timofei7/TiNZv1/schematics/engs31 - package map.graffle/image1.jpg

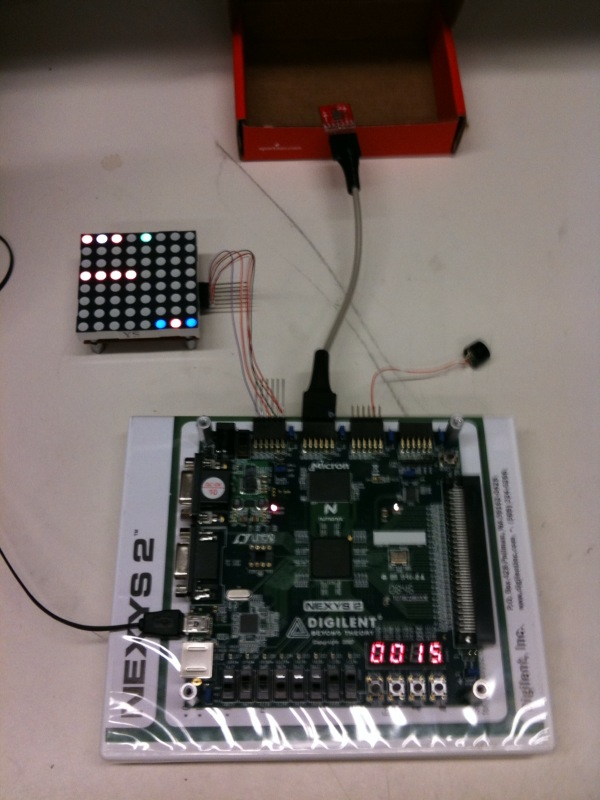
schematics/engs31 - package map.graffle/image1.jpg
