timofei7/TiNZv1/levelCreator/testphoto.jpg

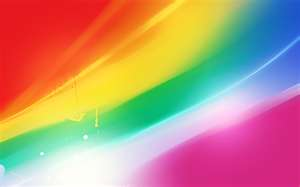
levelCreator/testphoto.jpg
