timofei7/TiNZv1/README.md

##TiNZ v1##

ENGS 31 - Summer 2009
Final Project

[Video Demo](http://www.youtube.com/embed/jcJoUI1PBZo?rel=0&amp;hd=1)

Our goal for this project was to create a simple, but addicting game that played off of old-fashioned handheld and vintage arcade games, but utilized newer technology that allowed for a more modern feel and the implementation of more exciting features. This is a reinvention of the original tilt-maze game as a digital moving maze on an RBG 8x8 LED matrix controlled via accelerometer.  It takes the tilt as input to move the player on the board.  There is seven-segment display showing the timer and score. A piezo is also included to produce different sounds for specific actions in the game. These components contribute to a gaming experience that is stimulating both tactilely, visually and aurally. The game design also makes the game easy to reprogram to include more levels and additional features.  The included maze designs include a multicolor fire-spewing dragon, a volcano, and an alien space ship with lasers.

##Detaiils##

The basic components of the project:

* Xilinx FPGA board
* VHDL (digital circuit) code
* Accelerometer chip
* LED multi-segment RGB display
* Piezo
* 3D case model (rapid prototyped)

Copyright 2009 Tim Tregubov and Divya Gunasekaran

<br /><span xmlns:dct="http://purl.org/dc/terms/" href="http://purl.org/dc/dcmitype/Text" property="dct:title" rel="dct:type">TiNZ v1</span> by <a xmlns:cc="http://creativecommons.org/ns#" href="https://github.com/timofei7/TiNZv1" property="cc:attributionName" rel="cc:attributionURL">Divya Gunasekaran and Tim Tregubov</a> is licensed under a <a rel="license" href="http://creativecommons.org/licenses/by-nc-sa/3.0/">Creative Commons Attribution-NonCommercial-ShareAlike 3.0 Unported License</a>
