timofei7/TiNZv1/schematics/frontpanel.graffle/QuickLook/Preview.pdf

TINZ - Front Panel

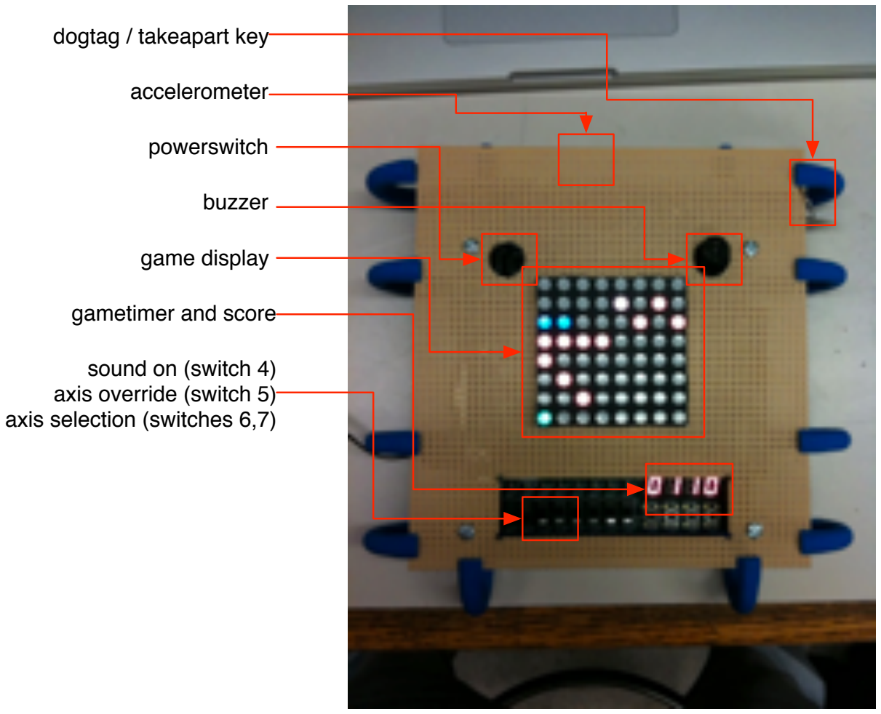
[picture p7: figure]
powerswitch; buzzer; game display; gametimer and score; sound on (switch 4) axis override (switch 5) axis selection (switches 6,7); accelerometer; dogtag / takeapart key
