timofei7/TiNZv1/schematics/engs31 - package map.graffle/QuickLook/Preview.pdf

TINZ - Package Map

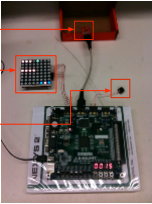
[picture p8: figure]

Sparkfun
8x8 RGB Serial LED

Sparkfun ADXL213AE
Breakout Board

Piezo Buzzer
CEM-1203(42)
