timofei7/TiNZv1/schematics/frontpanel.graffle/image1.jpg

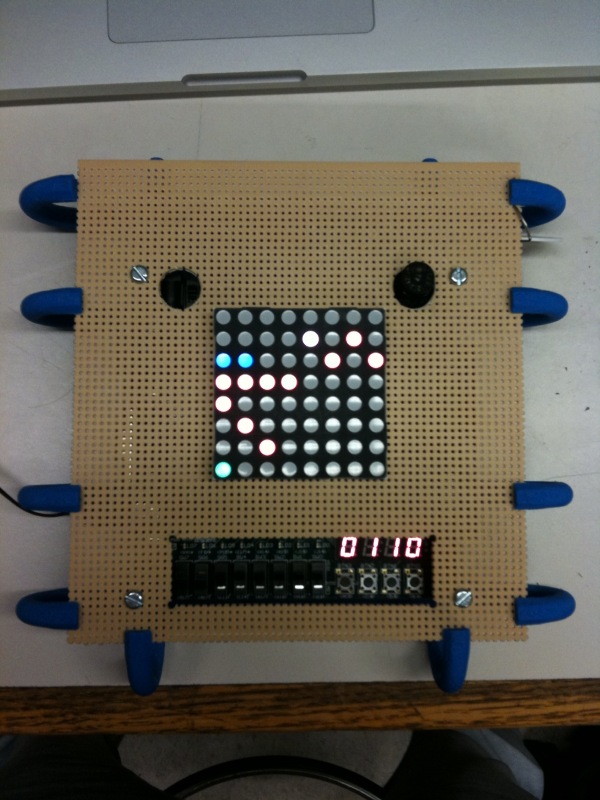
schematics/frontpanel.graffle/image1.jpg
