timofei7/TiNZv1/Project/LEDDriver.vhd

----------------------------------------------------------------------------------
-- DARTMOUTH COLLEGE - ENGS31
-- Divya Gunasekaran and Tim Tregubov
-- Final Project
-- September 1, 2009
-- 
-- Create Date:    13:17:46 08/15/2009 
-- Design Name: 
-- Module Name:    LEDDriver - Behavioral
-- Project Name: 	 TINZ (This Is Not Zelda)
-- 
-- Description:    the SPI driver for the LED display
--
----------------------------------------------------------------------------------
library IEEE;
use IEEE.STD_LOGIC_1164.ALL;
use ieee.numeric_std.all;

entity LEDDriver is
    Port ( Clk : in  STD_LOGIC;
           Data: in STD_LOGIC; --the data in bit from the data shift register from Display
           GoDisplay : in  STD_LOGIC;  --in from Display says data register is full up
           ShiftBitOut : out STD_LOGIC; --tells display I'm ready for the next bit
           displayDone : out STD_LOGIC; --tells display that we're done sending, do your thing. 
           --MISO : in  STD_LOGIC;
           MOSI : out  STD_LOGIC; --spi out to display
           SCLK : out  STD_LOGIC; --spi clock
           CS : out  STD_LOGIC);  --spi enable
end LEDDriver;

architecture Behavioral of LEDDriver is

   
-- state machine for SPI bus
type state_type is (sIdle, sInit, sWaitS, sSendInit, sSendDown, sSendM, sSendUP, sDeInit, sWaitD);	-- state machine
signal curr_state: state_type := sIdle;
signal next_state: state_type;

constant waitFinal: unsigned(14 downto 0) := "110000110101000"; -- 25,000 * 20ns = .5ms delay 
--constant waitFinal: unsigned(14 downto 0) := "000000000000100"; -- FOR TESTING - remember this counts from 0
signal waitCount: unsigned(14 downto 0) := (others => '0'); --counts for the initial wait
signal waitTC : std_logic:='0'; --terminal count
signal waitReset : std_logic:='0'; --reset the wait counter

--constant slowFinal: unsigned(7 downto 0) := "11111010"; --count to 250 for a rate of 100khz in for down/up of SCLK
constant slowFinal: unsigned(7 downto 0) := "11111010"; --FOR TESTING
signal slowCount: unsigned(7 downto 0) := (others => '0'); --counts for SCLK
signal slowTC : std_logic:='0'; --terminal count
signal slowReset : std_logic:='0'; --reset the wait counters

constant shiftFinal: unsigned(9 downto 0):= "1000000000"; --final count 512
signal shiftCount: unsigned(9 downto 0):= (others => '0'); --count shifts
signal shiftBit: std_logic:='0'; --shift our bits out onto MOSIs
signal shiftTC: std_logic:='0'; --shift terminal count

--signal displayDoneReg: std_logic:='1'; --low when I'm active high when I'm not

signal csy: std_logic:='0'; --internal CS sig

begin

MOSI <= Data; --we shift out datas from this shift register from Display
shiftBitOut <= shiftBit; --just a hookup of internal to external
displayDone <= csy; --do it or rather don't
CS <= csy;




waitCounter: --15bit up counter to enable .5ms pause
process(Clk)
   begin
      if rising_edge(Clk) then
         if waitReset = '1' then
            waitCount <= (others => '0');
         else
            waitCount <= waitCount + 1;
         end if;
      end if;
end process waitCounter;
waitTC <= '1' when waitCount = waitFinal else '0';


slowCounter: --15bit up counter to enable .5ms pause
process(Clk)
   begin
      if rising_edge(Clk) then
         if slowReset = '1' then
            slowCount <= (others => '0');
         else
            slowCount <= slowCount + 1;
         end if;
      end if;
end process slowCounter;
slowTC <= '1' when slowCount = slowFinal else '0';


shiftCounter: --just counts shifts so we don't ask for more than we need
process(Clk)
   begin
      if rising_edge(Clk) then
         if shiftTC = '1' then
            shiftCount <= (others => '0');
         elsif shiftBit = '1' then
            shiftCount <= shiftCount + 1;
         end if;
      end if;
end process shiftCounter;

statemachine: --state machine to do all the work
process(curr_state, GoDisplay, waitTC, shiftCount, slowTC, slowCount)
   begin
   next_state <= curr_state;
   csy <= '0'; --opposite default - this is active low but we only set it high false during sIdle
   shiftBit <= '0';
   waitReset <= '0';
   slowReset <= '0';
   SCLK <= '0';
   shiftTC <= '0';
   
   case curr_state is
      when sIdle => --base state - CS is high false
         csy <= '1';
         if GoDisplay = '1' then
            next_state <= sInit;
         end if;
      when sInit => --resest counters to deassert cs
         csy<= '1';
         waitReset <= '1';
         next_state <= sWaitS;
      when sWaitS => --wait for .5ms after deasserting cs
         if waitTC = '1' then
            next_state <= sSendInit;
         end if;
      when sSendInit => --reset counts to initialize sending cycle
         slowReset <= '1';
         shiftbit <= '1';
         next_state <= sSendDown;
      when sSendDown => --keep SCLK low for half an SCLK cycle
         if slowTC = '1' then
            next_state <= sSendM;
         end if;
      when sSendM => --reset slow counter -- could get rid of this and init states
         SCLK <= '1'; --start the up 
         slowReset <= '1';
         next_state <= sSendUP;
      when sSendUP =>
         SCLK <= '1'; --default is 0 so here's the rising edge for the slave!
         if slowTC = '1' then
            if shiftCount = shiftFinal then --are we done shifting?
               shiftTC <= '1';
               next_state <= sIdle;--sDeInit usually
            else
               next_state <= sSendInit;
            end if;
         end if;
--      when sDeInit => --NOT SURE WE NEED DELAY AT END --this is for CS to stay low for a little extra
--         waitReset <= '1';
--         next_state <= sWaitD;
--      when sWaitD => --wait for .5ms to denable cs
--         if waitTC = '1' then
--            next_state <= sIdle;
--         end if;
      when others => next_state <= sIdle;
   end case;
end process statemachine;


statechanger:
process (Clk)
begin
	if rising_edge(Clk) then --slow us down to at most 125khz
		curr_state <= next_state;
	end if;
end process statechanger;


end Behavioral;
