timofei7/TiNZv1/Project/Play.vhd

----------------------------------------------------------------------------------
-- DARTMOUTH COLLEGE - ENGS31
-- Divya Gunasekaran and Tim Tregubov
-- Final Project
-- September 1, 2009
-- 
-- Create Date:    08:51:16 08/19/2009 
-- Design Name: 
-- Module Name:    PlayerInput - Behavioral 
-- Project Name: 	 TINZ (This Is Not Zelda)
--
-- Description: This puts together the acclerometer and the player and the gametimer modules
----------------------------------------------------------------------------------
library IEEE;
use IEEE.STD_LOGIC_1164.ALL;
use IEEE.NUMERIC_STD.ALL;

entity Play is
    Port ( 
      Clk : in  STD_LOGIC;
      Xin : IN std_logic; --from accelerometer
      Yin : IN std_logic; --''
      XAnalogIn : IN std_logic; --need to hook up to analog input pins
      YAnalogIn : IN std_logic; --''
      XAnalogOut : OUT std_logic; --need to hook up to something to prevent errors
      YAnalogOut : OUT std_logic; --''
      
      SpeedRate: IN std_logic_vector(1 downto 0);
      LevelDifficulty: in STD_LOGIC_VECTOR(1 downto 0);
      
      resetPlayer : IN std_logic; --resets player pos
		moveEN : IN std_logic;		--enables move signals
      playerX : OUT std_logic_vector(2 downto 0); --current pos
      playerY : OUT std_logic_vector(2 downto 0); --''
      
      resetGameT : IN std_logic;
      sevenSegEN : IN std_logic;
      sevenSegSelector : IN std_logic;          
      gameOver : OUT std_logic;
		
		makeSoundMove : OUT std_logic_vector(2 downto 0);
      
      an  : OUT std_logic_vector(3 downto 0);
      seg : OUT std_logic_vector(0 to 6)
    );
end Play;

architecture Behavioral of Play is

COMPONENT ACCELDecoder
PORT(
   Clk : IN std_logic;
   Xin : IN std_logic;
   Yin : IN std_logic;
   SpeedRate: in std_logic_vector(1 downto 0);
   LevelDifficulty: in STD_LOGIC_VECTOR(1 downto 0);
   XAnalogIn : IN std_logic;
   YAnalogIn : IN std_logic;
   XAnalogOut : OUT std_logic;
   YAnalogOut : OUT std_logic;
   XMinus : OUT std_logic;
   XPlus : OUT std_logic;
   YMinus : OUT std_logic;
   YPlus : OUT std_logic
   );
END COMPONENT;

COMPONENT Player
PORT(
   Clk : IN std_logic;
   xPlus : IN std_logic;
   xMinus : IN std_logic;
   yPlus : IN std_logic;
   yMinus : IN std_logic;
   resetPlayer : IN std_logic;  
   moveEN : IN std_logic;
   playerX : OUT std_logic_vector(2 downto 0);
   playerY : OUT std_logic_vector(2 downto 0);
   moveCountOnes : OUT std_logic_vector(3 downto 0);
   moveCountTens : OUT std_logic_vector(3 downto 0);
   moveCountHundreds : OUT std_logic_vector(3 downto 0);
	makeSoundMove : OUT std_logic_vector(2 downto 0)
   );
END COMPONENT;


COMPONENT GameTimer
PORT(
   Clk : IN std_logic;
   resetGameT : IN std_logic;
   sevenSegEN : IN std_logic;
   numMovesOnes : IN std_logic_vector(3 downto 0);
   numMovesTens : IN std_logic_vector(3 downto 0);
   numMovesHundreds : IN std_logic_vector(3 downto 0);
   sevenSegSelector : IN std_logic;          
   gameOver : OUT std_logic;
   an : OUT std_logic_vector(3 downto 0);
   segDisplay : OUT std_logic_vector(0 to 6)
   );
END COMPONENT;



signal XMinus : std_logic; --internal pulse of detected move from accelerometer
signal XPlus : std_logic;  --''
signal YMinus : std_logic; --''
signal YPlus : std_logic;  --''

signal moveCountOnes : std_logic_vector(3 downto 0) :=(others => '0'); --move counter for displaying score
signal moveCountTens : std_logic_vector(3 downto 0) :=(others => '0'); --''
signal moveCountHundreds : std_logic_vector(3 downto 0) :=(others => '0');--''

begin


theaccelerometer: ACCELDecoder PORT MAP(
		Clk => Clk,
		Xin => Xin,
		Yin => Yin,
      SpeedRate => SpeedRate,
      LevelDifficulty => LevelDifficulty,
		XAnalogIn => XAnalogIn,
		YAnalogIn => YAnalogIn,
		XAnalogOut => XAnalogOut,
		YAnalogOut => YAnalogOut,
		XMinus => XMinus,
		XPlus => XPlus,
		YMinus => YMinus,
		YPlus => YPlus
	);
   
theplayer: Player PORT MAP(
		Clk => Clk,
		xPlus => XPlus,
		xMinus => XMinus,
		yPlus => YPlus,
		yMinus => YMinus,
		resetPlayer => resetPlayer,
		moveEN => moveEN,
		playerX => playerX,
		playerY => playerY,
		moveCountOnes => moveCountOnes,
		moveCountTens => moveCountTens,
		moveCountHundreds => moveCountHundreds,
		makeSoundMove => makeSoundMove
	);
   
   
timesup: GameTimer PORT MAP(
		Clk => Clk,
		resetGameT => resetGameT,
		sevenSegEN => sevenSegEN,
		numMovesOnes => moveCountOnes,
		numMovesTens => moveCountTens,
		numMovesHundreds => moveCountHundreds,
		sevenSegSelector => sevenSegSelector,
		gameOver => gameOver,
		an => an,
		segDisplay => seg
	);   
end Behavioral;
