timofei7/TiNZv1/Project/ThresHysteresis.vhd

----------------------------------------------------------------------------------
-- DARTMOUTH COLLEGE - ENGS31
-- Divya Gunasekaran and Tim Tregubov
-- Final Project
-- September 1, 2009
-- 
-- Create Date:    15:55:06 08/18/2009 
-- Design Name: 
-- Module Name:    ThresHysteresis - Behavioral
-- Project Name: 	 TINZ (This Is Not Zelda)
-- 
-- Description:    This does hysteresis thresholding on the accelerometer
--                 input and sends out an up or a down when it detects a valid movement
--
----------------------------------------------------------------------------------
library IEEE;
use IEEE.STD_LOGIC_1164.ALL;
use ieee.numeric_std.all;

entity ThresHysteresis is
    Port ( Clk : in  STD_LOGIC;
           SpeedRate : in STD_LOGIC_VECTOR(1 downto 0);
           SIN : in  STD_LOGIC_VECTOR (7 downto 0); --the signal input, post division, to theshold our moves on
           UP : out  STD_LOGIC;  --we have go +
           DOWN : out  STD_LOGIC); --we have go -
end ThresHysteresis;

architecture Behavioral of ThresHysteresis is

--constant upt: unsigned(7 downto 0)   := "10111111"; -- first try -- more sensitive
--constant uph: unsigned(7 downto 0)   := "10011111"; 
--constant downh: unsigned(7 downto 0) := "01111111"; 
--constant downt: unsigned(7 downto 0) := "01011111"; 

--constant upt: unsigned(7 downto 0)   := "11100110";  --this is for the messed up 75% skew. 
--constant uph: unsigned(7 downto 0)   := "11011011"; 
--constant downh: unsigned(7 downto 0) := "11000111"; 
--constant downt: unsigned(7 downto 0) := "10110101"; 

--constant upt: unsigned(7 downto 0)   := "10111011";  --this is in digilab with averaging
--constant uph: unsigned(7 downto 0)   := "10011111";  --and pretty heavy tilt
--constant downh: unsigned(7 downto 0) := "01101111"; 
--constant downt: unsigned(7 downto 0) := "01001110"; 

constant upt: unsigned(7 downto 0)   := "10110000";  --this is in digilab with some by hand reduction of above
constant uph: unsigned(7 downto 0)   := "10011100";  --and slightly less heavy tilt
constant downh: unsigned(7 downto 0) := "01101100"; 
constant downt: unsigned(7 downto 0) := "01011111"; 

signal sins: unsigned(7 downto 0);
signal waitReset: std_logic;
signal waitcount: unsigned(24 downto 0) := (others => '0');
constant waitcountfinal1: unsigned(24 downto 0) := "1111111111111111111111111"; --slower
constant waitcountfinal2: unsigned(24 downto 0) := "0111111111111111111111111"; --slow
constant waitcountfinal3: unsigned(24 downto 0) := "0011111111111111111111111"; --fast
constant waitcountfinal4: unsigned(24 downto 0) := "0001111111111111111111111"; --faster
signal waitcountfinal: unsigned(24 downto 0):= (others => '0');
signal waitTC : std_logic;

type state_type is (sStart, sSendUP, sSendDOWN, sWaitU, sWaitD);	-- state machine
signal curr_state, next_state: state_type;


begin

process(SpeedRate)
begin
   case SpeedRate is
      when "00" =>
         waitcountfinal <= waitcountfinal1;
      when "01" =>
         waitcountfinal <= waitcountfinal1; --don't change speed turns out it is too hard otherwise
      when "10" =>
         waitcountfinal <= waitcountfinal1;
      when "11" =>
         waitcountfinal <= waitcountfinal1;
      when others =>
         waitcountfinal <= waitcountfinal1;
   end case;
end process;


sins <= unsigned(SIN);

--this is the timer responsible for the move repeat rate!
waitcounter:
process(Clk)
   begin
      if rising_edge(Clk) then
         if waitReset = '1' then
            waitcount <= (others => '0');
         else
            waitcount <= waitcount + 1;
         end if;
       end if;
end process;
waitTC <= '1' when waitcount = waitcountfinal else '0';

--hysteresis
Detect:
process(curr_state, sins, waitTC)
   begin
      next_state <= curr_state;
      UP <= '0';
      DOWN <= '0';
      waitReset <= '0';
      
      case curr_state is
         when sStart =>
            if sins >= upt then
               next_state <= sSendUP;
				elsif sins <= downt then
					next_state <= sSendDOWN;
            end if;
         when sSendUP =>
            UP <= '1';
            waitReset <= '1';
            next_state <= sWaitU;
         when sSendDown =>
            DOWN <= '1';
            waitReset <= '1';
            next_state <= sWaitD;
         when sWaitD =>
            if sins >= downh then
               next_state <= sStart;
            elsif waitTC = '1' then
               next_state <= sSendDown;
            end if;
         when sWaitU =>
            if sins <= uph then
               next_state <= sStart;
            elsif waitTC = '1' then
               next_state <= sSendUP;
            end if;
         when others => next_state <= sStart;
      end case;
end process Detect;




StateSwitcher:
process (Clk)
begin
	if rising_edge(Clk) then
		curr_state <= next_state;
	end if;
end process StateSwitcher;



end Behavioral;
