timofei7/TiNZv1/(commit log)

2009-08-13 more stuffs gameboard started but doesn't simulate, added module for counter with generics
    [AttrLookup.vhd, ClockDivider.vhd, GameBoard.vhd, GameBoard_TB.vhd, Sequences.vhd]
2009-08-16 leddriver initial effort, needs work but maybe will work? ahaha has some stupid timing hacks
2009-08-16 redid some of leddriver and now its broken but closer to what its supposed to do stupid SCLK
    [LEDDriver.vhd]
2009-08-18 lots of accelerometer work also LEDS work!
2009-08-18 decoder better ledtest and start of hysteresis
2009-08-19 project updated with player and accell stufffs fixed testbench view stuff that was showing up in the implementation hierarchy
    [ACCELDecoder.vhd, ACCELDecoder_TB.vhd, AccelDetector.vhd, GameBoardROM_TB.vhd, GameBoard_TB.vhd, LEDDriver_TB.vhd, Player.vhd, PlayerTB.vhd]
2009-08-20 updated display, gameboard, led merged
2009-08-22 lots of stuff fixed, display, accelerometer, averaging, hysterisis, started noise, still to fix gamelogic and noise, and design scripts
    [ACCELDecoder.vhd, AccelDetector.vhd, AccelFilter.vhd, AccelFilter_TB.vhd, Display.vhd, GameBoard_TB.vhd, GameLogicFSM.vhd, LEDDriver.vhd]
2009-08-22 noises bad design though
    [Noise.vhd, Noise_TB.vhd, Noises.vhd]
2009-08-22 noises incorporated (need to work into game controller etc) and some little changes
    [Noise.vhd, Noises.vhd, PlayerColor.vhd, cellGame.vhd]
2009-08-24 some new stuff, intro sequence. need to debug why sometimes poweup lets you die
2009-08-26 cell game with heatseekers
2009-08-26 heat seekers baby!
2009-08-26 working game just missing levels
    [HeatSeeker.vhd, Noises.vhd, positionCounter.vhd]
2009-08-26 presentation powerpoint
2009-08-30 some code cleanup, remove TESTOUT and added a couple comments, not much really. Tested and it still works.
